bemcgarvey/RCtoUSB/README.md

# RCtoUSB - Wireless Joystick Dongle for RC flight sims
 
Allows an inexpensive Spektrum sattelite receiver to connect to a computer via usb as a joystick.
Works with most RC flight sims such as RealFlight 9.5
