bemcgarvey/RCtoUSB/Schematic/RCtoUSB/RCtoUSB.kicad_pcb

## KiCad design Schematic/RCtoUSB/RCtoUSB.kicad_pcb (2022-01-19)

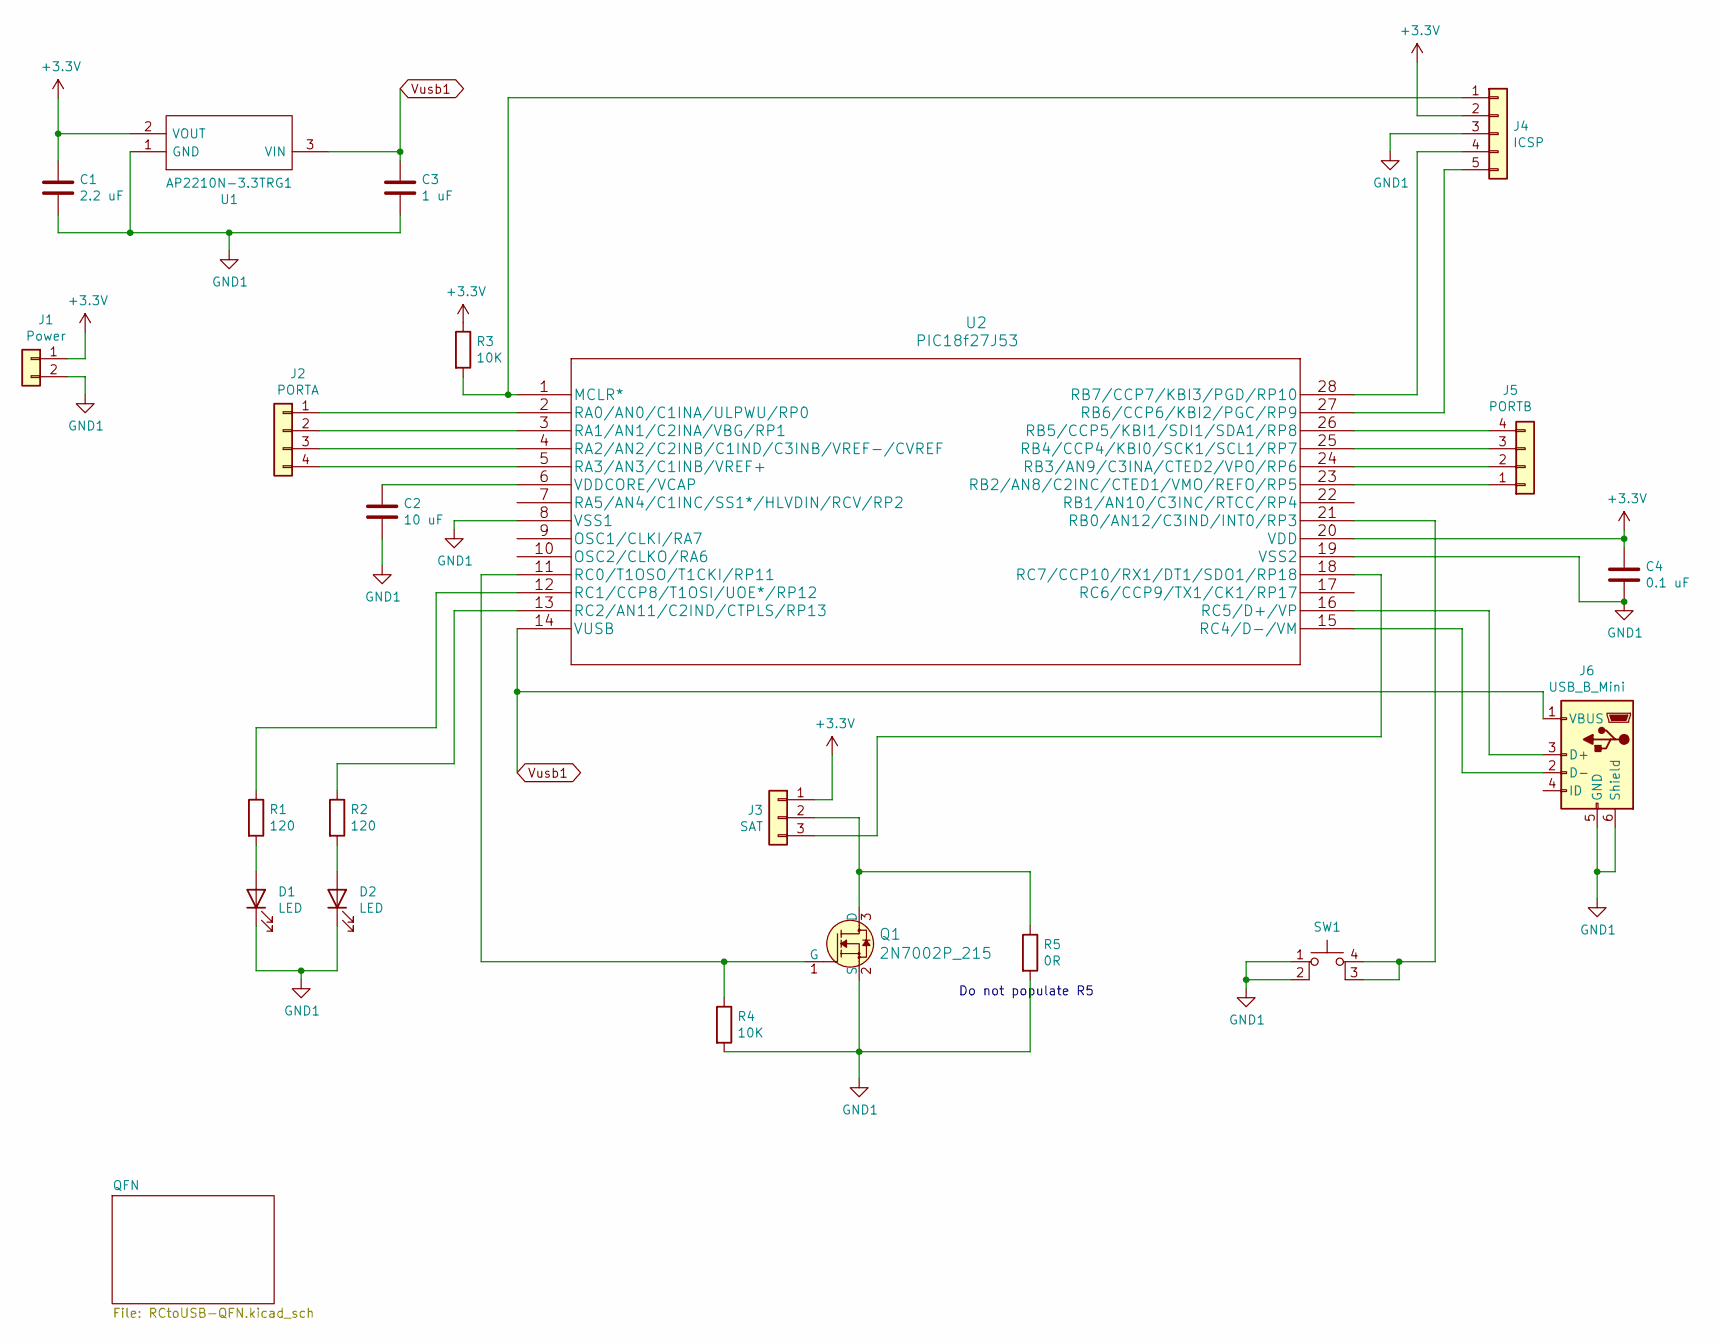
[picture p1: schematic RCtoUSB.kicad_sch]

Parts:
C1: 2.2 uF; C_0805_2012Metric
C2: 10 uF; C_0805_2012Metric
C3: 1 uF; C_0805_2012Metric
C4: 0.1 uF; C_0805_2012Metric
D1, D2: LED; LED_0805_2012Metric
J1: Power; PinSocket_1x02_P2.54mm_Vertical
J2: PORTA; PinSocket_1x04_P2.54mm_Vertical
J3: SAT; JST_ZH_B3B-ZR_1x03_P1.50mm_Vertical
J4: ICSP; PinHeader_1x05_P2.54mm_Vertical
J5: PORTB; PinSocket_1x04_P2.54mm_Vertical
J6: USB_B_Mini; USB_Mini-B_Wuerth_65100516121_Horizontal
Q1: 2N7002P_215; SOT-23-3; MPN 2N7002P,215; Digi-Key_PN 1727-4692-1-ND
R1, R2: 120; R_0805_2012Metric
R3, R4: 10K; R_0805_2012Metric
R5: 0R; R_0805_2012Metric
SW1: SW_MEC_5E; FSM16JH
U1: AP2210N-3.3TRG1; SOT95P280X145-3N; Mouser Part Number 621-AP2210N-3.3TRG1
U2: PIC18f27J53; pic18f27j53-i&slash_so

Connections:
GND1: C1.2, C2.2, C3.2, C4.2, D1.1 (K), D2.1 (K), J1.2, J4.3, J6.5 (GND), J6.6 (Shield), Q1.2 (S), R4.2, R5.2, SW1.1, SW1.2, U1.1 (GND), U2.8 (VSS1), U2.19 (VSS2); also elsewhere on the board
unnamed: C2.1, U2.6 (VDDCORE/VCAP)
unnamed: D1.2 (A), R1.2
unnamed: D2.2 (A), R2.2
unnamed: J2.1, U2.2 (RA0/AN0/C1INA/ULPWU/RP0)
unnamed: J2.2, U2.3 (RA1/AN1/C2INA/VBG/RP1)
unnamed: J2.3, U2.4 (RA2/AN2/C2INB/C1IND/C3INB/VREF-/CVREF)
unnamed: J2.4, U2.5 (RA3/AN3/C1INB/VREF+)
unnamed: J3.2, Q1.3 (D), R5.1
unnamed: J3.3, U2.18 (RC7/CCP10/RX1/DT1/SDO1/RP18)
unnamed: J4.1, R3.2, U2.1 (MCLR*)
unnamed: J4.4, U2.28 (RB7/CCP7/KBI3/PGD/RP10)
unnamed: J4.5, U2.27 (RB6/CCP6/KBI2/PGC/RP9)
unnamed: J5.1, U2.23 (RB2/AN8/C2INC/CTED1/VMO/REFO/RP5)
unnamed: J5.2, U2.24 (RB3/AN9/C3INA/CTED2/VPO/RP6)
unnamed: J5.3, U2.25 (RB4/CCP4/KBI0/SCK1/SCL1/RP7)
unnamed: J5.4, U2.26 (RB5/CCP5/KBI1/SDI1/SDA1/RP8)
unnamed: J6.2 (D-), U2.15 (RC4/D-/VM)
unnamed: J6.3 (D+), U2.16 (RC5/D+/VP)
unnamed: Q1.1 (G), R4.1, U2.11 (RC0/T1OSO/T1CKI/RP11)
unnamed: R1.1, U2.12 (RC1/CCP8/T1OSI/UOE*/RP12)
unnamed: R2.1, U2.13 (RC2/AN11/C2IND/CTPLS/RP13)
unnamed 38: SW1.3 (K), SW1.4 (A), U2.21 (RB0/AN12/C3IND/INT0/RP3); also elsewhere on the board
Vusb1: C3.1, J6.1 (VBUS), U1.3 (VIN), U2.14 (VUSB)

Notes on the sheet:
Do not populate R5

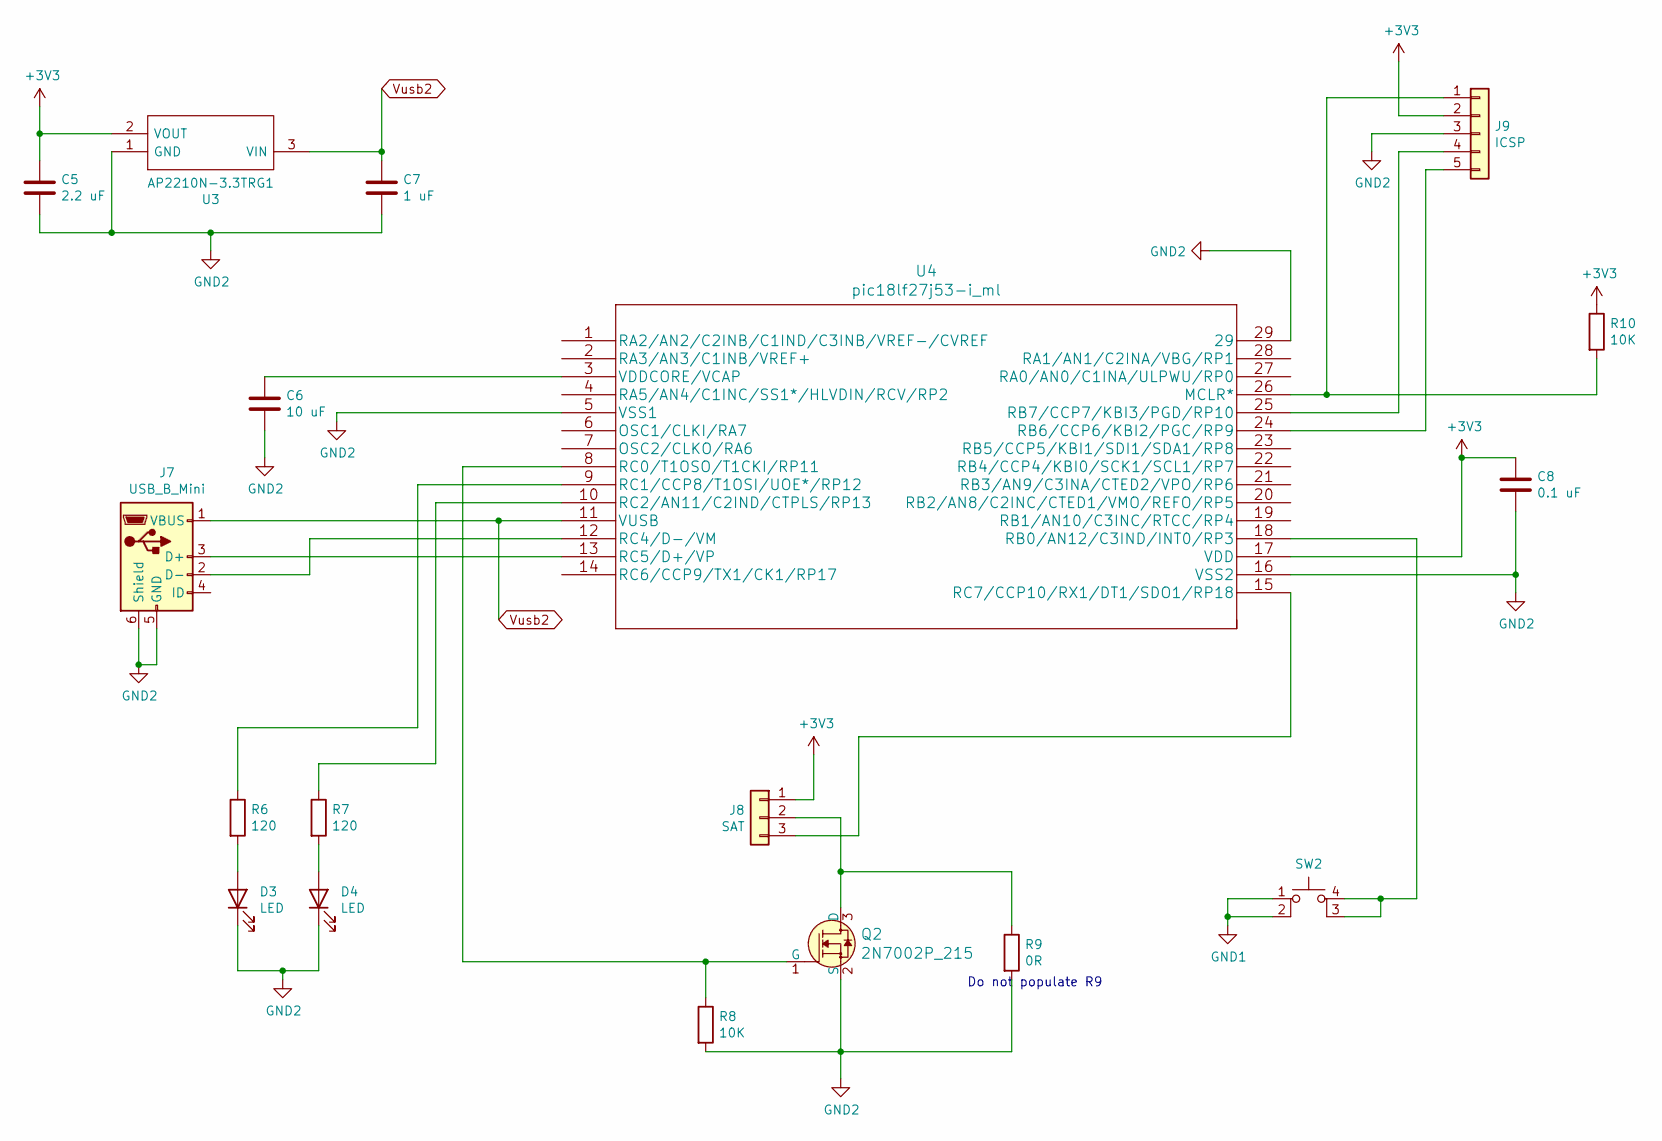
[picture p2: schematic RCtoUSB-QFN.kicad_sch, RCtoUSB QFN version]

Parts:
C5: 2.2 uF; C_0603_1608Metric
C6: 10 uF; C_0603_1608Metric
C7: 1 uF; C_0603_1608Metric
C8: 0.1 uF; C_0603_1608Metric
D3, D4: LED; LED_0603_1608Metric
J7: USB_B_Mini; USB_Mini-B_Wuerth_65100516121_Horizontal
J8: SAT; JST_ZH_B3B-ZR_1x03_P1.50mm_Vertical
J9: ICSP; PinHeader_1x05_P2.54mm_Vertical
Q2: 2N7002P_215; SOT-23-3; MPN 2N7002P,215; Digi-Key_PN 1727-4692-1-ND
R6, R7: 120; R_0603_1608Metric
R8, R10: 10K; R_0603_1608Metric
R9: 0R; R_0603_1608Metric
SW2: SW_MEC_5E; FSM16JH
U3: AP2210N-3.3TRG1; SOT95P280X145-3N; Mouser Part Number 621-AP2210N-3.3TRG1
U4: pic18lf27j53-i_ml; pic18lf27j53-i&slash_ml

Connections:
GND2: C5.2, C6.2, C7.2, C8.2, D3.1 (K), D4.1 (K), J7.5 (GND), J7.6 (Shield), J9.3, Q2.2 (S), R8.2, R9.2, U3.1 (GND), U4.5 (VSS1), U4.16 (VSS2), U4.29; also elsewhere on the board
unnamed: C6.1, U4.3 (VDDCORE/VCAP)
unnamed: D3.2 (A), R6.2
unnamed: D4.2 (A), R7.2
unnamed: J7.2 (D-), U4.12 (RC4/D-/VM)
unnamed: J7.3 (D+), U4.13 (RC5/D+/VP)
unnamed: J8.2, Q2.3 (D), R9.1
unnamed: J8.3, U4.15 (RC7/CCP10/RX1/DT1/SDO1/RP18)
unnamed: J9.1, R10.2, U4.26 (MCLR*)
unnamed: J9.4, U4.25 (RB7/CCP7/KBI3/PGD/RP10)
unnamed: J9.5, U4.24 (RB6/CCP6/KBI2/PGC/RP9)
unnamed: Q2.1 (G), R8.1, U4.8 (RC0/T1OSO/T1CKI/RP11)
unnamed: R6.1, U4.9 (RC1/CCP8/T1OSI/UOE*/RP12)
unnamed: R7.1, U4.10 (RC2/AN11/C2IND/CTPLS/RP13)
unnamed 39: SW2.3 (K), SW2.4 (A), U4.18 (RB0/AN12/C3IND/INT0/RP3); also elsewhere on the board
unnamed: SW2.1, SW2.2
Vusb2: C7.1, J7.1 (VBUS), U3.3 (VIN), U4.11 (VUSB)

Notes on the sheet:
Do not populate R9

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
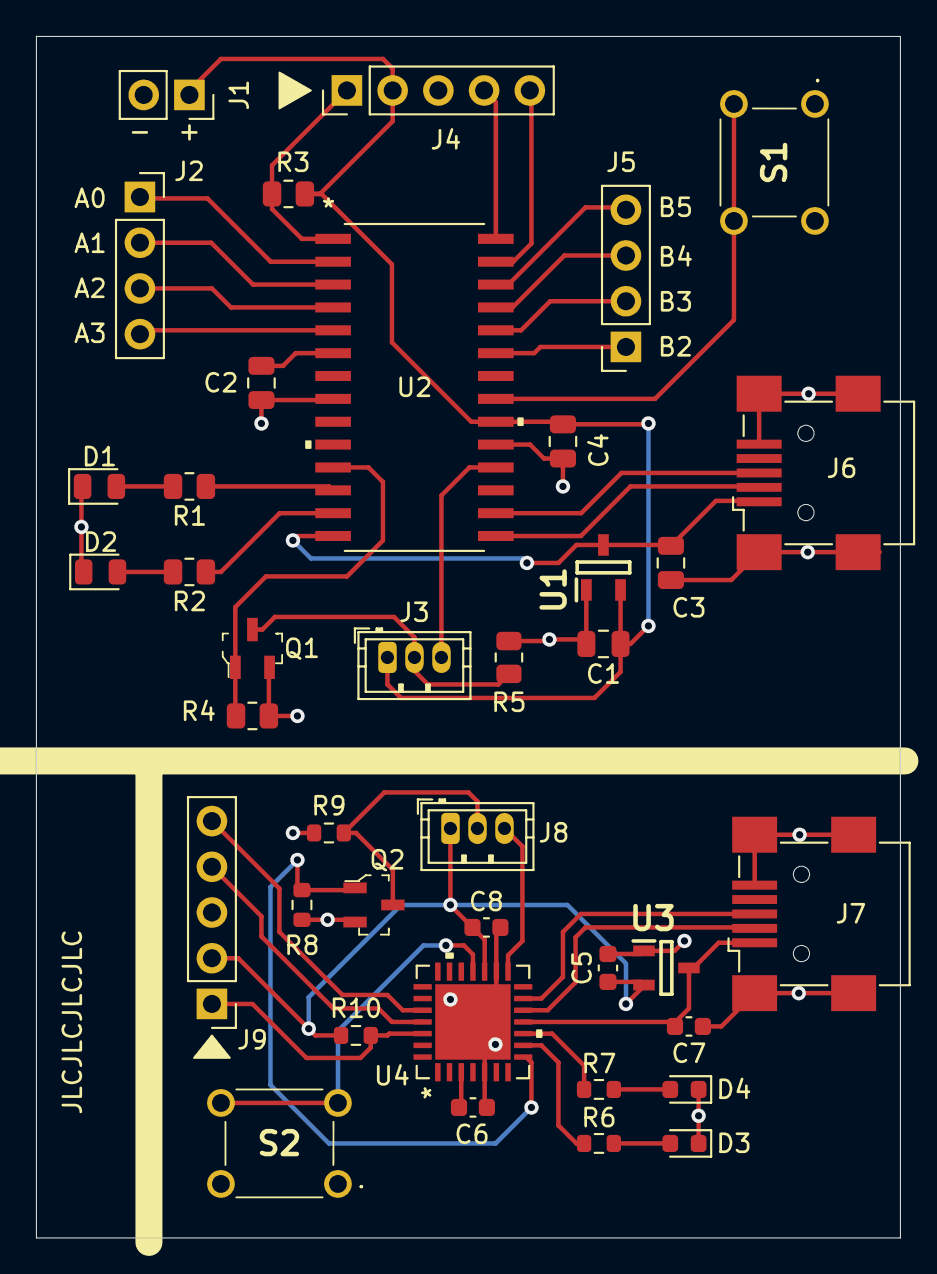
[picture p3: board RCtoUSB.kicad_pcb from above]

Board: 2 copper layers, 48.0 x 66.8 mm, 39 parts (0 on the bottom side), 41 nets.

Other parts of the board:
S1, S2: FSM16JH

Their connections:
GND1: S1.1, S1.2; also elsewhere on the board
GND2: S2.1, S2.2; also elsewhere on the board
unnamed 38: S1.3, S1.4; also elsewhere on the board
unnamed 39: S2.3, S2.4; also elsewhere on the board
