bemcgarvey/RCtoUSB/Firmware/RCtoUSB.X/timers.h

/* 
 * File:   timers.h
 * Author: bemcg
 *
 * Created on August 23, 2021, 11:45 AM
 */

#ifndef TIMERS_H
#define	TIMERS_H

extern volatile uint16_t systemTimerTicks;

void initSystemTimer(void);


#endif	/* TIMERS_H */
