bemcgarvey/RCtoUSB/(commit log)

2021-07-23 Kicad project created
    [RCtoUSB.kicad_pcb, RCtoUSB.sch]
2021-07-25 Initial Schematics - SOIC and QFN
    [RCtoUSB-QFN.sch, RCtoUSB.sch]
2021-07-25 Added some breakout connectors to SOIC version
    [RCtoUSB-QFN.sch, RCtoUSB.sch]
2021-07-26 Fixed footprints for breakout connectors
    [RCtoUSB.sch]
2021-07-27 PCB layout
    [RCtoUSB-QFN.sch, RCtoUSB.kicad_pcb, RCtoUSB.sch]
2021-07-28 Finished schematic and pcb
    [RCtoUSB-QFN.sch, RCtoUSB.kicad_pcb, RCtoUSB.sch]
2021-08-03 Changed ID pin to floating on USB connector
    [RCtoUSB-QFN.sch, RCtoUSB.kicad_pcb, RCtoUSB.sch]
2021-08-03 Generated gerbers
    [RCtoUSB-B_Cu.gbr, RCtoUSB-B_Mask.gbr, RCtoUSB-B_SilkS.gbr, RCtoUSB-Edge_Cuts.gbr, RCtoUSB-F_Cu.gbr, RCtoUSB-F_Mask.gbr, RCtoUSB-F_SilkS.gbr, RCtoUSB-NPTH.drl]
2021-08-23 Flight Simulation Device hid descriptor
2021-08-23 button and timer working
2021-08-25 Bind button short and long press working
    [joystick.c, main.c, satellite.c, satellite.h]
2021-08-25 Improved button functionality
2021-08-29 Fixed buttons. Removed long press to reset
    [joystick.c, main.c, satellite.c]
2021-10-16 Improved switch symbol in schematic
    [RCtoUSB-QFN.sch, RCtoUSB.sch]
2022-01-19 Converted to KiCad 6
    [RCtoUSB-QFN.kicad_sch, RCtoUSB-QFN.sch, RCtoUSB.kicad_pcb, RCtoUSB.kicad_sch, RCtoUSB.sch]
